haldean/sousvide/README.md

sousvide PID control and web UI
==



To use, hook up the SV2.1 controller to your raspberry pi's GPIO [as described
here](http://haldean.org/sousvide) and run `go build; ./sousvide`.
