haldean/sousvide/id/relay-shield.stl

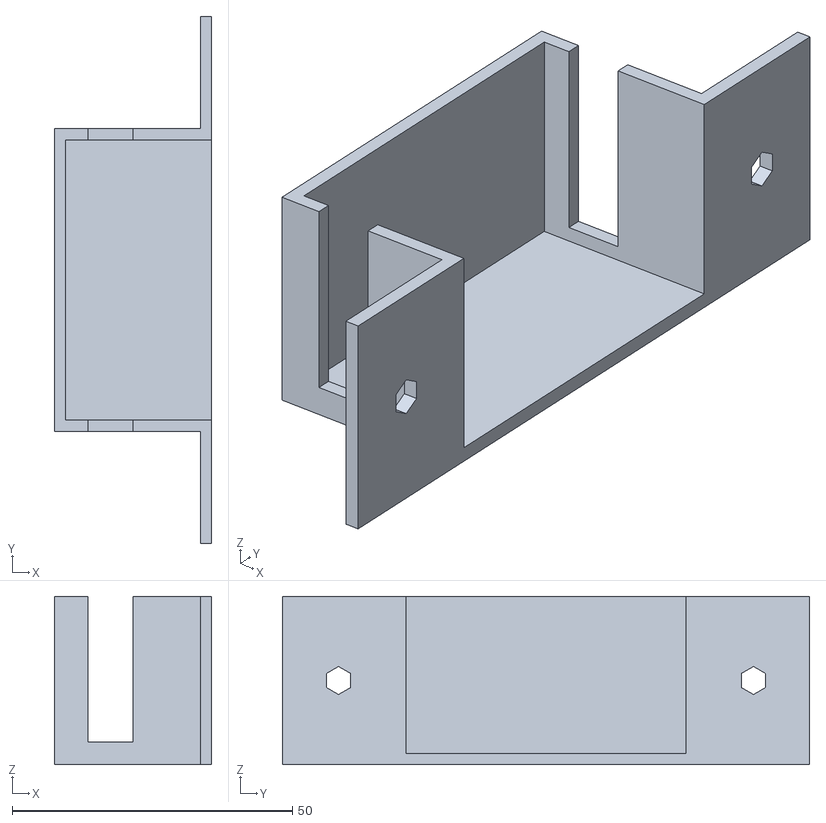
[picture p1: CAD file, 2014-02-21]
id/relay-shield.stl
28.0 x 94.0 x 30.0
