haldean/sousvide/pcb/sousvide.pdf

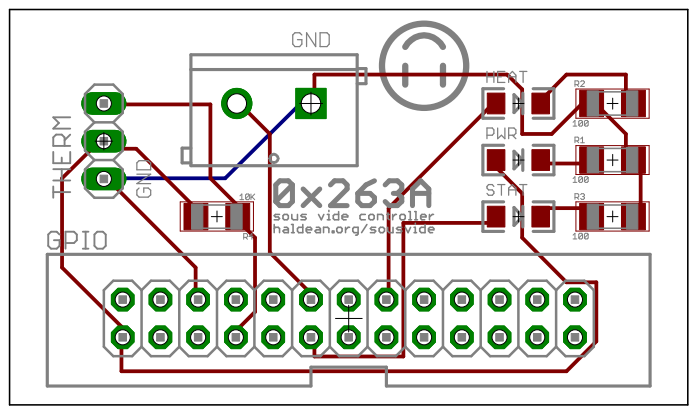
[picture p2: page 1]
