haldean/sousvide/pcb/sousvide.brd

## EAGLE design pcb/sousvide.brd (2013-08-18)

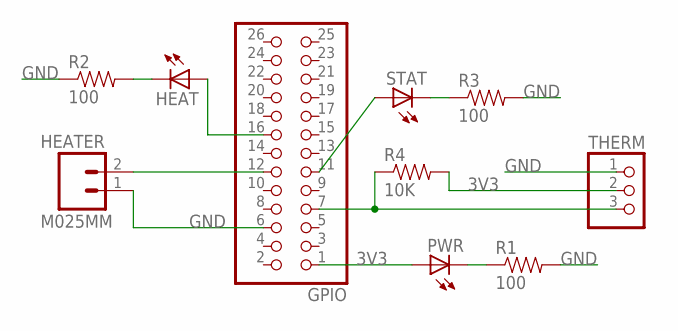
[picture p3: schematic sousvide.sch]

Parts:
GPIO: PINHD-2X13; 2X13
HEAT: LED1206; LED-1206
HEATER: M025MM; SCREWTERMINAL-5MM-2
PWR: LED1206; LED-1206
R1, R2, R3: 100; 1206
R4: 10K; 1206
STAT: LED1206; LED-1206
THERM: PINHD-1X3; 1X03

Connections:
3V3: GPIO.1, PWR.A, R4.2, THERM.2
GND: GPIO.6, HEATER.1, R1.2, R2.1, R3.2, THERM.1
unnamed: PWR.C, R1.1
unnamed: GPIO.12, HEATER.2
unnamed: R3.1, STAT.C
unnamed: GPIO.16, HEAT.A
unnamed: HEAT.C, R2.2
unnamed: GPIO.11, STAT.A
unnamed: GPIO.7, R4.1, THERM.3

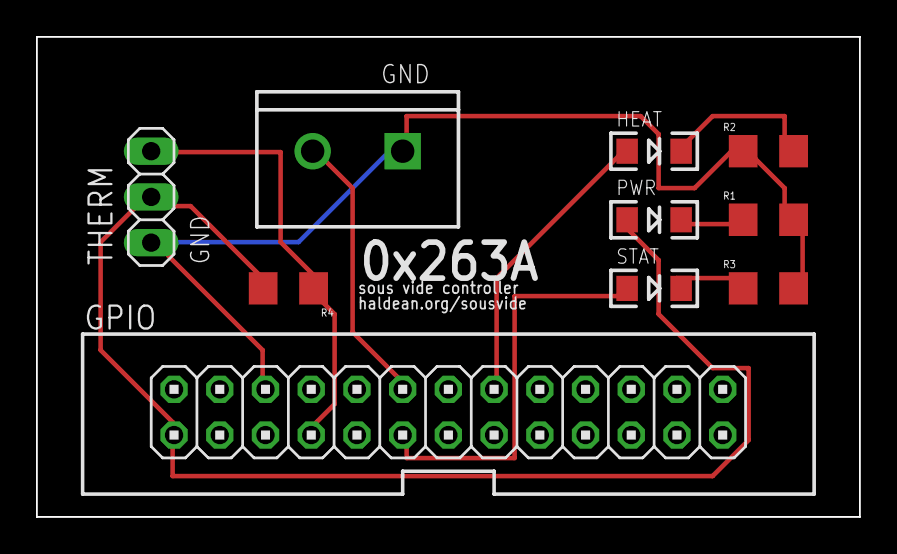
[picture p4: board sousvide.brd from above]

Board: 2 copper layers, 45.7 x 26.7 mm, 10 parts (0 on the bottom side), 9 nets.
