haldean/sousvide/(commit log)

2013-07-28 Damn I did a lot of work on this without commiting.
    May I forever live in shame. This generates a live-updating site with fake data
    that allows for changing of the target temperature. It also generates SVG charts
    using vdobler's charts library. The dependencies in the README are a subset of
    the actual dependencies, I forgot to keep track until after I had started.
2013-07-29 Add ability to tune PID params from web interface
2013-07-31 Add GPIO heater relay support.
2013-07-31 Add fake temperature file, fix temperature parsing
2013-08-05 A few fixes from testing.
    Changes:
    - Don't take out locks when reading; the rpi can't keep up
    - Set the default to be zero degrees
    - Increase the heater read interrupt timer
2013-08-05 Save PID values and load on start
2013-08-06 New chart backend working with raw SVG output.
    Needed to do this to allow for drawing when the heater is on/off in the graph.
2013-08-06 Switch to using polylines for graphing.
2013-08-11 Add timers.
    Note that in-browser sounds don't work yet, the only indication that a
    timer is done is that it expires and the font turns red.
2013-08-11 Fix timer implementation, and make noise work.
2013-08-15 Add PCB source files to the repository.
    [sousvide.brd, sousvide.sch]
2013-08-18 Fix bug in PCB.
    The first one dropped too much over the LED in line with the heater relay, so
    the heater relay never flipped. This removes the LED in line with the heater and
    replaces it with an LED on a separate pin.
    Important lesson learned: always breadboard your designs before you fab them.
    [sousvide.brd, sousvide.sch]
2013-10-16 Starting to look pretty!
    Still missing plots, which is big, as well as temperature setting. Need some
    sort of ajaxy progress indicator for actions like enable/disable.
2013-10-17 Implement animated theme switching because reasons
    Oh man now it does this awesome thing where it switches color when you
    switch it from enabled to disabled and it's super fucking sweet.
2013-10-17 Add a few files missing.
    oh by the way I switched from ender to jquery, whoops.
2013-10-17 Move timer JS into its own file
2013-10-17 Add temperature and PID editor.
    This is now (pretty much!) fully featured! I'm going to add some more
    animations because I fucking love animations.
2013-10-17 Change /target and /pid to be handled by /params
    This simplifies the form stuff a lot.
2013-10-18 Add heating indicator
2013-10-23 Add relay shield with compiled STL.
    The relay shield is used to mask the relay contacts so I can't
    electrocute myself quite as easily. It is _not_ an Arduino shield.
    [relay-shield.scad, relay-shield.stl]
2013-10-23 Change relay shield to have slightly more accurate dims
    [relay-shield.scad, relay-shield.stl]
2013-10-25 Rearrange shield for easier printing
    [relay-shield.scad, relay-shield.stl]
2014-02-21 Starting to work on V3!
    Some minor fixes to the relay shield, and a new (boring) part, which is a mount
    for the heaters.
    [relay-shield.scad, relay-shield.stl]
